matt-aranha/ASIP_para_Robo_Seguidor_de_Linha/documentation/Datapath_Diagrama.png

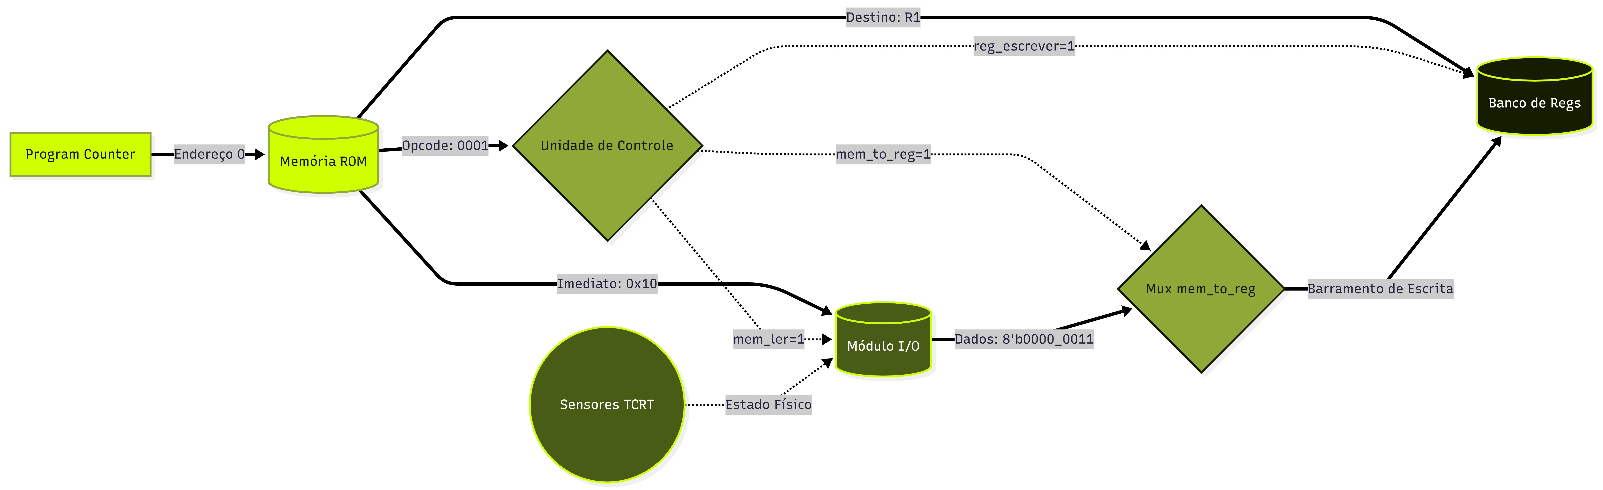
documentation/Datapath_Diagrama.png
