matt-aranha/ASIP_para_Robo_Seguidor_de_Linha/documentation/Flow_Summary.png

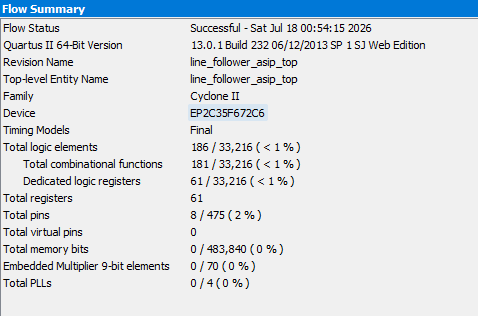
documentation/Flow_Summary.png
