matt-aranha/ASIP_para_Robo_Seguidor_de_Linha/documentation/FPGA_ED2_DCOMP.jpg

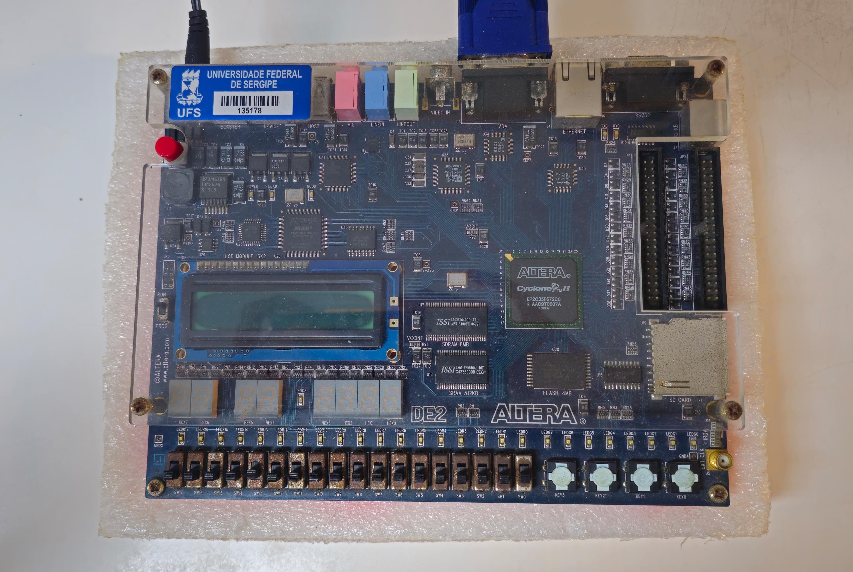
documentation/FPGA_ED2_DCOMP.jpg
