matt-aranha/ASIP_para_Robo_Seguidor_de_Linha/documentation/Pin_Assignments_for_the_clock_inputs.png

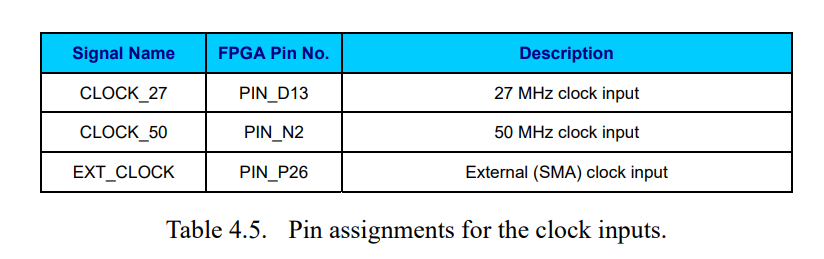
documentation/Pin_Assignments_for_the_clock_inputs.png
