matt-aranha/ASIP_para_Robo_Seguidor_de_Linha/documentation/Pin_assignments_for_the_expansion_headers.png

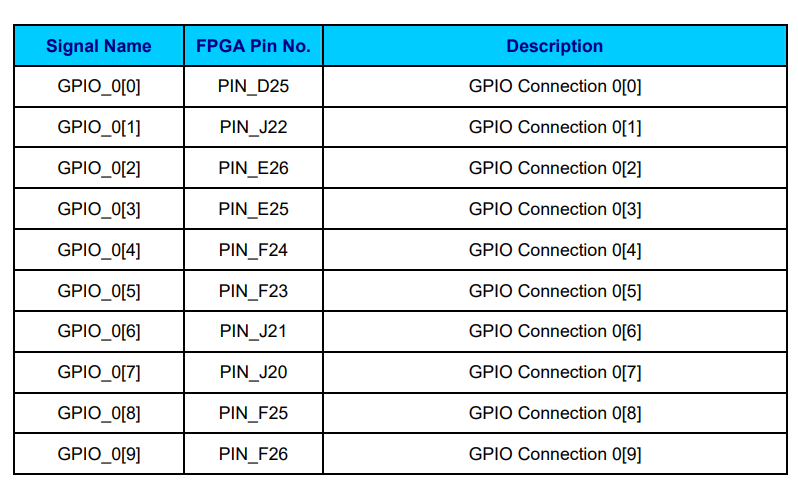
documentation/Pin_assignments_for_the_expansion_headers.png
