matt-aranha/ASIP_para_Robo_Seguidor_de_Linha/documentation/Top_View-Wire_Bond_(Cyclone_II-EP2C35F672C6).png

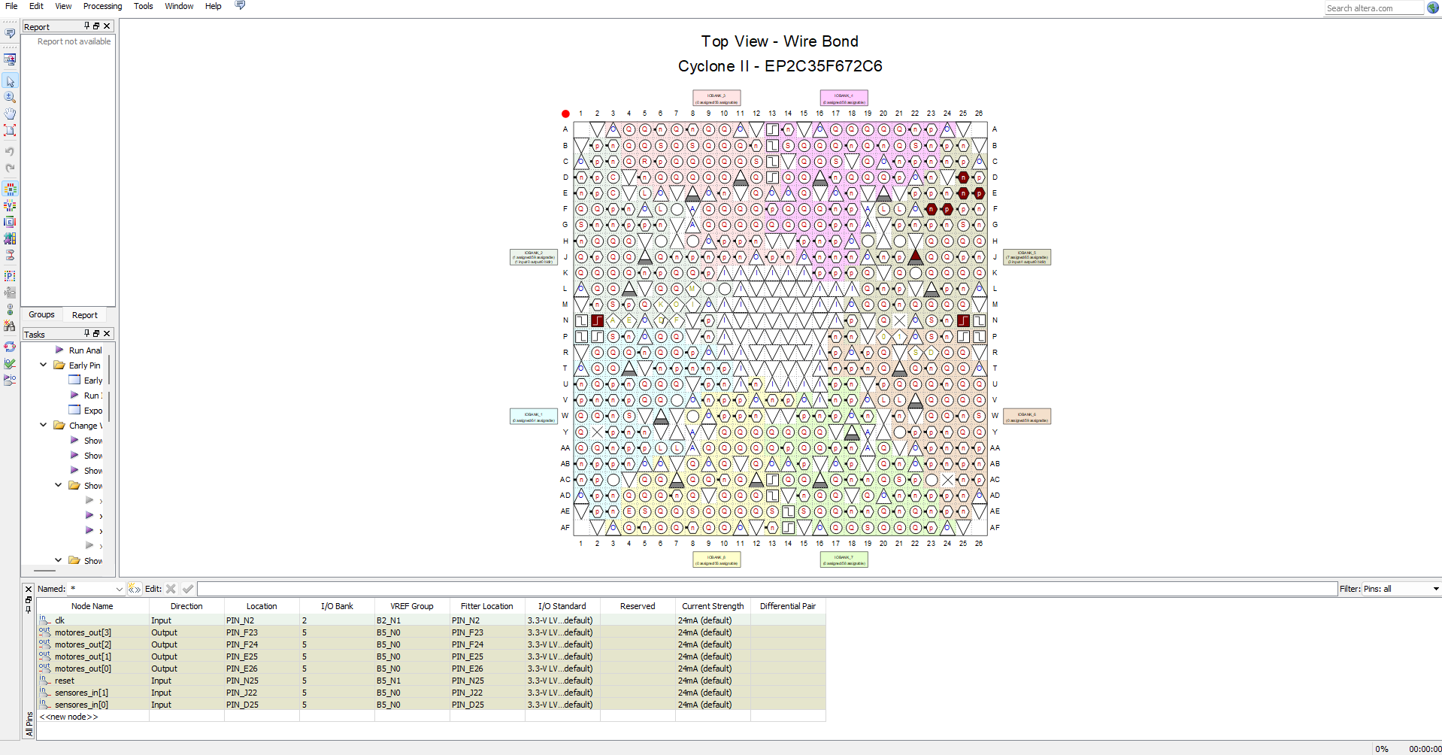
documentation/Top_View-Wire_Bond_(Cyclone_II-EP2C35F672C6).png
