matt-aranha/ASIP_para_Robo_Seguidor_de_Linha/(commit log)

2026-07-18 feat: adiciona arquivos de projeto do Quartus II 13.0 sp1
2026-07-18 docs: adiciona imagens de documentação
2026-07-18 Feat: adiciona arquivos para emular na S-Board da Pitanga
2026-07-18 Feat(README.md): adiciona seção extra - Simulação na S-Board da Pitanga
2026-07-18 Docs: acrescenta links para os arquivos da Pitanga
